ttzytt/hardware_vga_driver/Logisim/imgs/timing_diagram.png

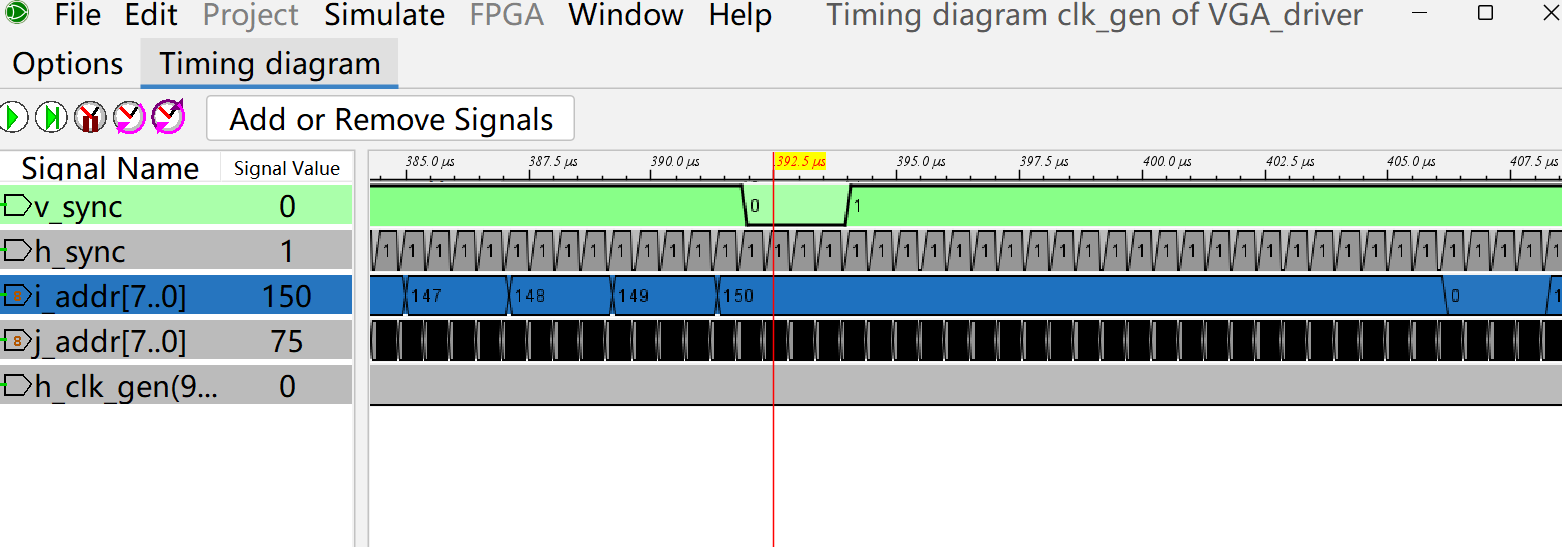
Logisim/imgs/timing_diagram.png
