ttzytt/hardware_vga_driver/Proposal/flowchart_v2.drawio.png

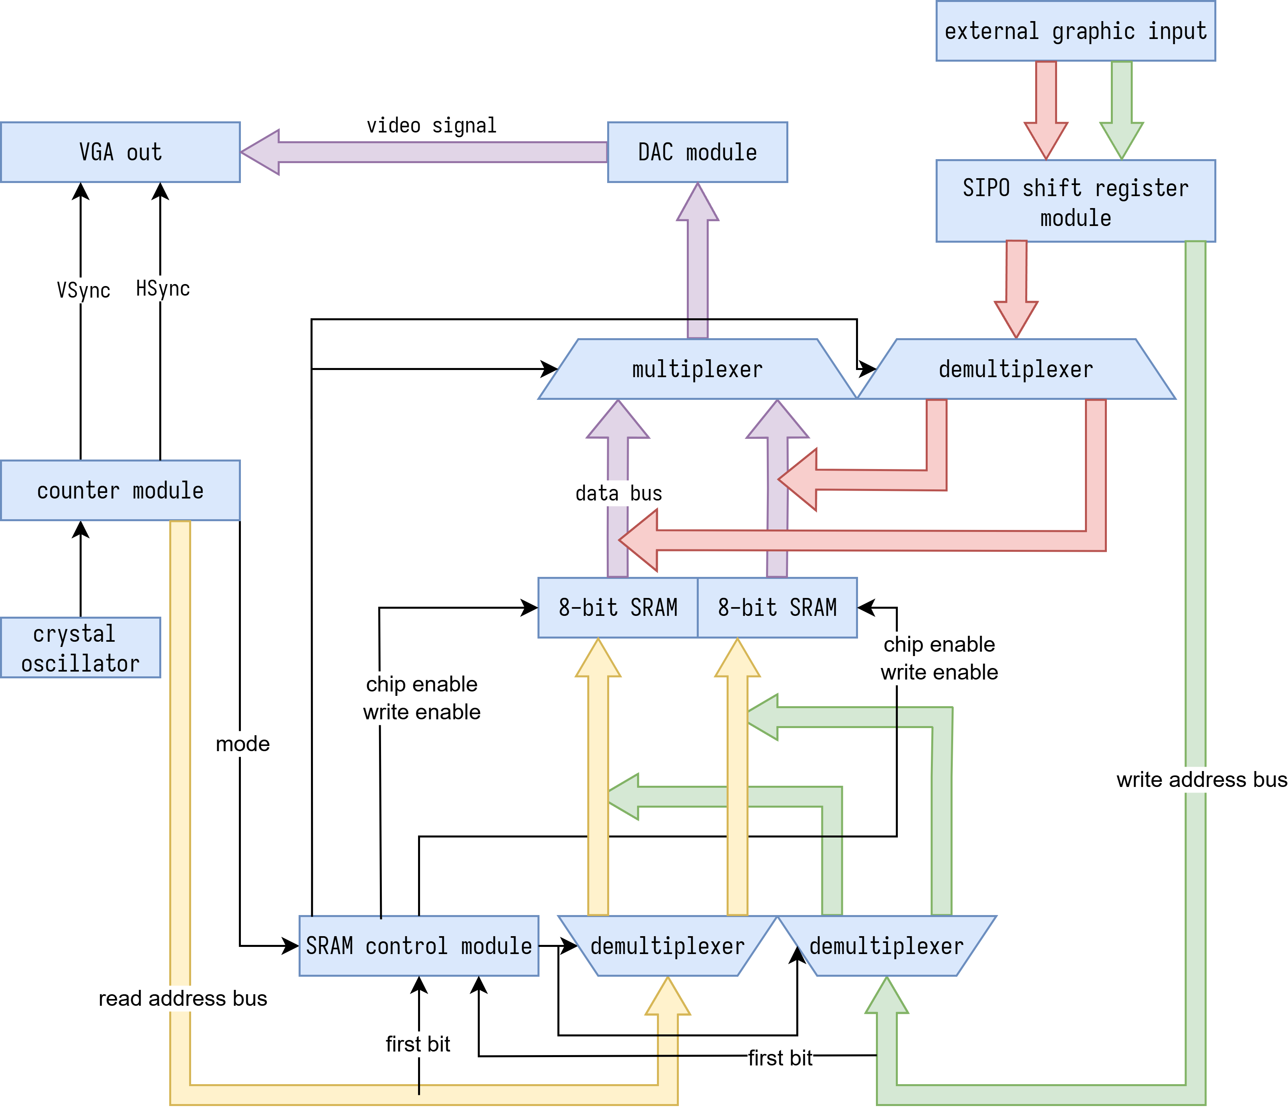
Proposal/flowchart_v2.drawio.png
