ttzytt/hardware_vga_driver/Proposal/flowchart.drawio.pdf

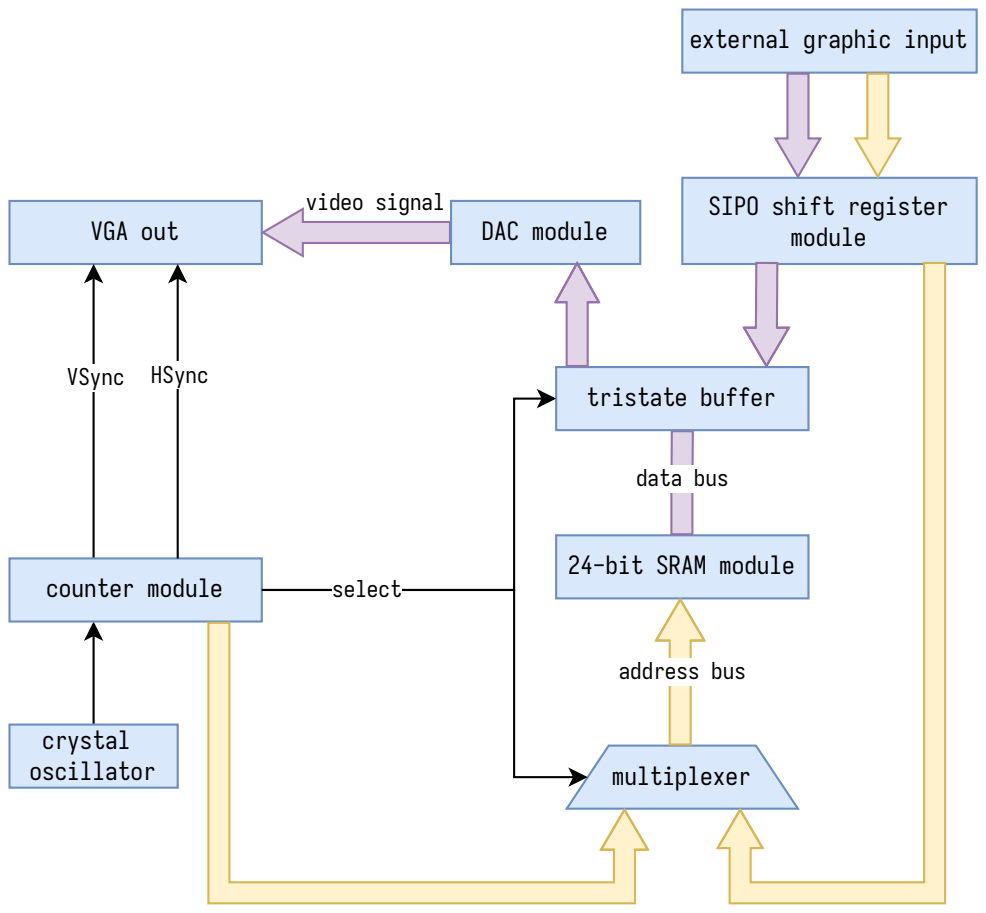
[picture p3: page 1]
VGA out; crystal oscillator; VSync; counter module; multiplexer; data; bus; HSync; address bus; tristate buffer; video signal; DAC module; select

external graphic input

SIPO shift register
module

24-bit SRAM module
