ttzytt/hardware_vga_driver/Proposal/flowchart_v2.drawio.pdf

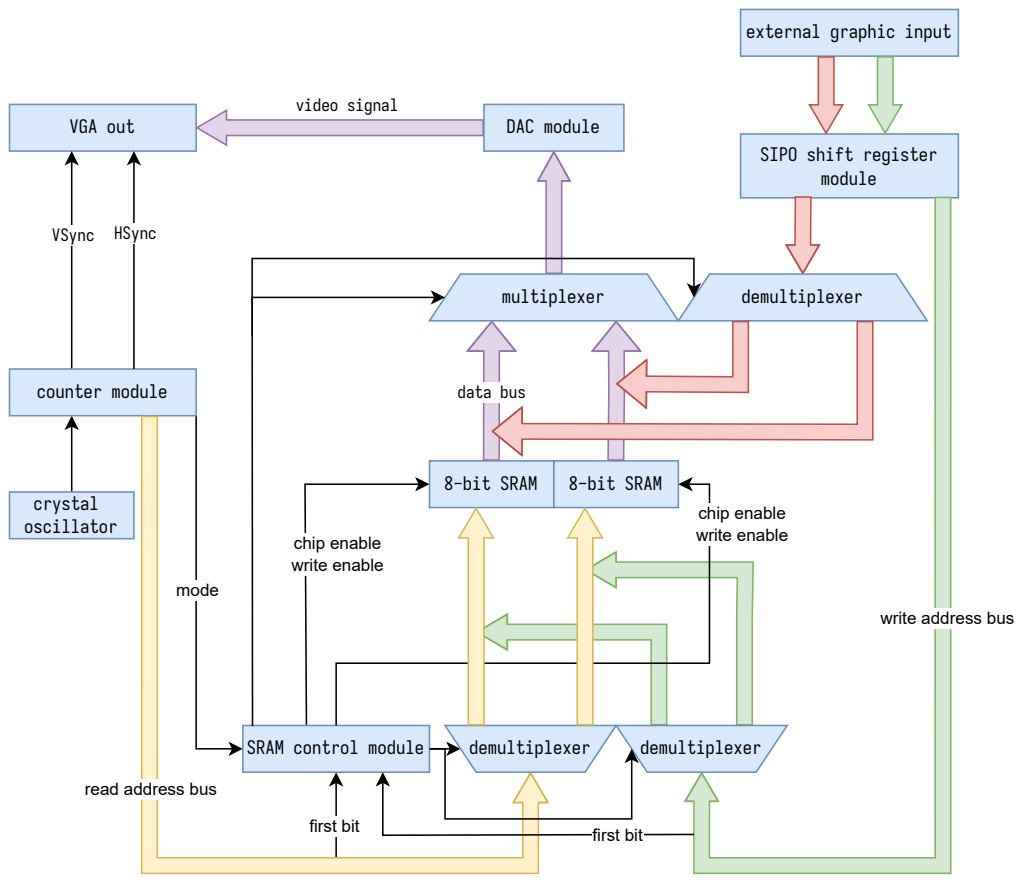
[picture p4: page 1]
first bit; VGA out; crystal oscillator; VSync; counter module; data bus; HSync; video signal; DAC module; SRAM control module; demultiplexer; multiplexer

external graphic input

SIPO shift register
module

8-bit SRAM | 8-bit SRAM

chip enable write enable

mode

write address bus

read address bus
