ttzytt/hardware_vga_driver/(list of files, drawings)

Other design files:
Logisim/VGA_driver.sync-conflict-20251006-233125-D54WMQZ.circ
