ttzytt/hardware_vga_driver/KiCAD/vga_video_card.kicad_pcb

## KiCad design KiCAD/vga_video_card.kicad_pcb (2025-11-28)

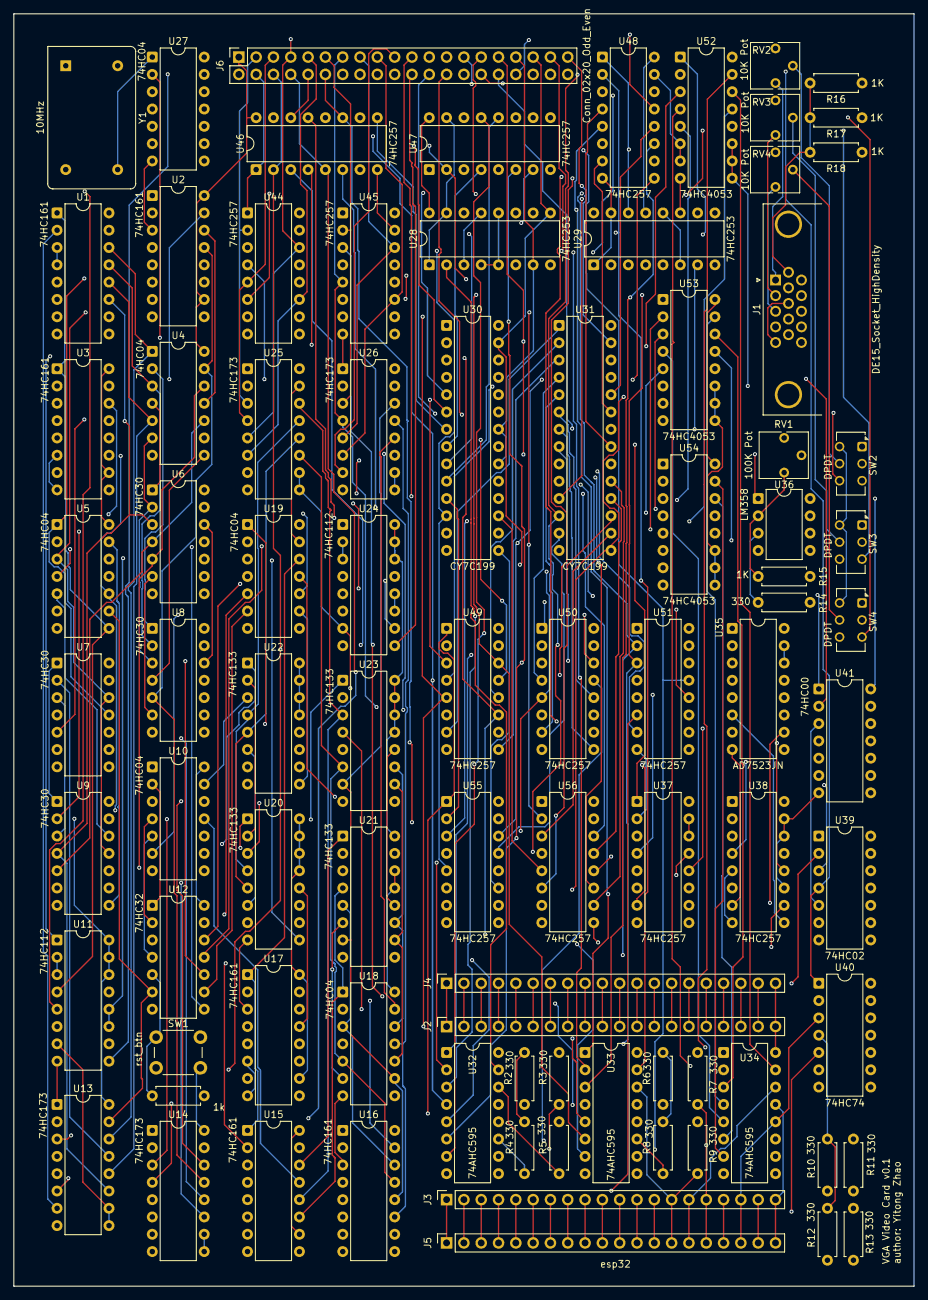
[picture p5: board vga_video_card.kicad_pcb from above]

Board: 4 copper layers, 132.1 x 186.7 mm, 87 parts (0 on the bottom side), 231 nets.

Parts:
J1: DE15_Socket_HighDensity; DSUB-15-HD_Socket_Horizontal_P2.29x1.90mm_EdgePinOffset3.03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
J2, J3, J4, J5: Conn_01x20; PinSocket_1x20_P2.54mm_Vertical
J6: Conn_02x20_Odd_Even; PinSocket_2x20_P2.54mm_Vertical
R1: 1k; R_Axial_DIN0207_L6.3mm_D2.5mm_P7.62mm_Horizontal
R2, R3, R4, R5, R6, R7, R8, R9, R10, R11, R12, R13, R14: 330; R_Axial_DIN0207_L6.3mm_D2.5mm_P7.62mm_Horizontal
R15, R16, R17, R18: 1K; R_Axial_DIN0207_L6.3mm_D2.5mm_P7.62mm_Horizontal
RV1: 100K Pot; Potentiometer_Vishay_T73YP_Vertical
RV2, RV3, RV4: 10K Pot; Potentiometer_Vishay_T73YP_Vertical
SW1: rst_btn; SW_PUSH_6mm
SW2, SW3, SW4: DPDT; SW_CK_JS202011CQN_DPDT_Straight
U1, U2, U3, U15, U16, U17: 74HC161; DIP-16_W7.62mm
U4, U5, U10, U18, U19, U27: 74HC04; DIP-14_W7.62mm
U6, U7, U8, U9: 74HC30; DIP-14_W7.62mm
U11, U24: 74HC112; DIP-16_W7.62mm
U12: 74HC32; DIP-14_W7.62mm
U13, U14, U25, U26: 74HC173; DIP-16_W7.62mm
U20, U21, U22, U23: 74HC133; DIP-16_W7.62mm
U28, U29: 74HC253; DIP-16_W7.62mm
U30, U31: CY7C199; DIP-28_W7.62mm
U32, U33, U34: 74AHC595; DIP-16_W7.62mm
U35: AD7523JN; DIP-16_W7.62mm
U36: LM358; DIP-8_W7.62mm
U37, U38, U44, U45, U46, U47, U48, U49, U50, U51, U55, U56: 74HC257; DIP-16_W7.62mm
U39: 74HC02; DIP-14_W7.62mm
U40: 74HC74; DIP-14_W7.62mm
U41: 74HC00; DIP-14_W7.62mm
U52, U53, U54: 74HC4053; DIP-16_W7.62mm
Y1: 10MHz; Oscillator_DIP-14

Connections:
+5V: J2.20, J4.20, J6.1, R2.2, R3.2, R4.2, R5.2, R6.2, R7.2, R8.2, R9.2, R10.2, R11.2, R12.2, R13.2, SW1.2, U1.7 (CEP), U1.10 (CET), U1.16 (VCC), U2.7 (CEP), U2.10 (CET), U2.16 (VCC), U3.7 (CEP), U3.10 (CET), U3.16 (VCC), U4.14 (VCC), U5.14 (VCC), U6.14 (VCC), U7.14 (VCC), U8.14 (VCC), U9.14 (VCC), U10.14 (VCC), U11.14 (~R), U11.15 (~R), U11.16 (VCC), U12.14 (VCC), U13.16 (VCC), U14.16 (VCC), U15.7 (CEP), U15.10 (CET), U15.16 (VCC), U16.7 (CEP), U16.10 (CET), U16.16 (VCC), U17.7 (CEP), U17.10 (CET), U17.16 (VCC), U18.14 (VCC), U19.14 (VCC), U20.13, U20.14, U20.15, U20.16 (VCC), U21.13, U21.14, U21.15, U21.16 (VCC), U22.13, U22.14, U22.15, U22.16 (VCC), U23.13, U23.14, U23.15, U23.16 (VCC), U24.14 (~R), U24.15 (~R), U24.16 (VCC), U25.16 (VCC), U26.16 (VCC), U27.14 (VCC), U28.3 (I3a), U28.10 (I0b), U28.11 (I1b), U28.13 (I3b), U28.16 (VCC), U29.6 (I0a), U29.10 (I0b), U29.12 (I2b), U29.13 (I3b), U29.16 (VCC), U30.28 (VCC), U31.28 (VCC), U32.16 (VCC), U33.16 (VCC), U34.16 (VCC), U35.14 (VCC), U35.15 (VREF), U36.8 (V+), U37.16 (VCC), U38.16 (VCC), U39.14 (VCC), U40.2 (D), U40.4 (~S), U40.14 (VCC), U41.14 (VCC), U44.16 (VCC), U45.16 (VCC), U46.16 (VCC), U47.16 (VCC), U48.16 (VCC), U49.16 (VCC), U50.16 (VCC), U51.16 (VCC), U52.16 (VDD), U53.16 (VDD), U54.16 (VDD), U55.16 (VCC), U56.16 (VCC), Y1.1 (EN), Y1.14 (Vcc)
/ADC_module/D0: U35.13 (D0(LSB)), U37.4 (Za)
/ADC_module/D1: U35.12 (D1), U37.7 (Zb)
/ADC_module/D2: U35.11 (D2), U37.12 (Zc)
/ADC_module/D3: U35.10 (D3), U37.9 (Zd)
/ADC_module/D4: U35.9 (D4), U38.4 (Za)
/ADC_module/D5: U35.8 (D5), U38.7 (Zb)
/ADC_module/D6: U35.7 (D6), U38.12 (Zc)
/ADC_module/D7: U35.6 (D7), U38.9 (Zd)
/ADC_module/I0: U37.3 (I1a), U55.4 (Za)
/ADC_module/I1: U37.6 (I1b), U55.7 (Zb)
/ADC_module/I2: U37.13 (I1c), U55.12 (Zc)
/ADC_module/I3: U37.10 (I1d), U55.9 (Zd)
/ADC_module/I4: U38.3 (I1a), U56.4 (Za)
/ADC_module/I5: U38.6 (I1b), U56.7 (Zb)
/ADC_module/I6: U38.13 (I1c), U56.12 (Zc)
/ADC_module/I7: U38.10 (I1d), U56.9 (Zd)
/RAM0_~CE: J6.33, U28.7 (Za), U30.20 (~CE), U30.22 (~OE)
/RAM0_~WE: J6.35, U28.9 (Zb), U30.27 (~WE), U41.1
/RAM1_~CE: J6.37, U29.7 (Za), U31.20 (~CE), U31.22 (~OE)
/RAM1_~WE: J6.39, U29.9 (Zb), U31.27 (~WE), U41.2
/RAM_module/RAM0_a0: U30.21 (A0), U44.4 (Za)
/RAM_module/RAM0_a1: U30.23 (A1), U44.7 (Zb)
/RAM_module/RAM0_a2: U30.24 (A2), U44.12 (Zc)
/RAM_module/RAM0_a3: U30.25 (A3), U44.9 (Zd)
/RAM_module/RAM0_a4: U30.26 (A4), U45.4 (Za)
/RAM_module/RAM0_a5: U30.1 (A5), U45.7 (Zb)
/RAM_module/RAM0_a6: U30.2 (A6), U45.12 (Zc)
/RAM_module/RAM0_a7: U30.3 (A7), U45.9 (Zd)
/RAM_module/RAM0_a8: U30.4 (A8), U46.4 (Za)
/RAM_module/RAM0_a9: U30.5 (A9), U46.7 (Zb)
/RAM_module/RAM0_a10: U30.6 (A10), U46.12 (Zc)
/RAM_module/RAM0_a11: U30.7 (A11), U46.9 (Zd)
/RAM_module/RAM0_a12: U30.8 (A12), U47.4 (Za)
/RAM_module/RAM0_a13: U30.9 (A13), U47.7 (Zb)
/RAM_module/RAM0_a14: U30.10 (A14), U47.12 (Zc)
/RAM_module/RAM0_d0: U30.11 (D0), U52.13 (X1), U55.2 (I0a)
/RAM_module/RAM0_d1: U30.12 (D1), U52.1 (Y1), U55.5 (I0b)
/RAM_module/RAM0_d2: U30.13 (D2), U52.3 (Z1), U55.14 (I0c)
/RAM_module/RAM0_d3: U30.15 (D3), U53.13 (X1), U55.11 (I0d)
/RAM_module/RAM0_d4: U30.16 (D4), U53.1 (Y1), U56.2 (I0a)
/RAM_module/RAM0_d5: U30.17 (D5), U53.3 (Z1), U56.5 (I0b)
/RAM_module/RAM0_d6: U30.18 (D6), U54.13 (X1), U56.14 (I0c)
/RAM_module/RAM0_d7: U30.19 (D7), U54.1 (Y1), U56.11 (I0d)
/RAM_module/RAM1_a0: U31.21 (A0), U48.4 (Za)
/RAM_module/RAM1_a1: U31.23 (A1), U48.7 (Zb)
/RAM_module/RAM1_a2: U31.24 (A2), U48.12 (Zc)
/RAM_module/RAM1_a3: U31.25 (A3), U48.9 (Zd)
/RAM_module/RAM1_a4: U31.26 (A4), U49.4 (Za)
/RAM_module/RAM1_a5: U31.1 (A5), U49.7 (Zb)
/RAM_module/RAM1_a6: U31.2 (A6), U49.12 (Zc)
/RAM_module/RAM1_a7: U31.3 (A7), U49.9 (Zd)
/RAM_module/RAM1_a8: U31.4 (A8), U50.4 (Za)
/RAM_module/RAM1_a9: U31.5 (A9), U50.7 (Zb)
/RAM_module/RAM1_a10: U31.6 (A10), U50.12 (Zc)
/RAM_module/RAM1_a11: U31.7 (A11), U50.9 (Zd)
/RAM_module/RAM1_a12: U31.8 (A12), U51.4 (Za)
/RAM_module/RAM1_a13: U31.9 (A13), U51.7 (Zb)
/RAM_module/RAM1_a14: U31.10 (A14), U51.12 (Zc)
/RAM_module/RAM1_d0: U31.11 (D0), U52.12 (X0), U55.3 (I1a)
/RAM_module/RAM1_d1: U31.12 (D1), U52.2 (Y0), U55.6 (I1b)
/RAM_module/RAM1_d2: U31.13 (D2), U52.5 (Z0), U55.13 (I1c)
/RAM_module/RAM1_d3: U31.15 (D3), U53.12 (X0), U55.10 (I1d)
/RAM_module/RAM1_d4: U31.16 (D4), U53.2 (Y0), U56.3 (I1a)
/RAM_module/RAM1_d5: U31.17 (D5), U53.5 (Z0), U56.6 (I1b)
/RAM_module/RAM1_d6: U31.18 (D6), U54.12 (X0), U56.13 (I1c)
/RAM_module/RAM1_d7: U31.19 (D7), U54.2 (Y0), U56.10 (I1d)
/RAM_module/RAM_bus_mux/w_addr0: U33.15 (QA), U44.3 (I1a), U48.2 (I0a)
/RAM_module/RAM_bus_mux/w_addr1: U33.1 (QB), U44.6 (I1b), U48.5 (I0b)
/RAM_module/RAM_bus_mux/w_addr2: U33.2 (QC), U44.13 (I1c), U48.14 (I0c)
/RAM_module/RAM_bus_mux/w_addr3: U33.3 (QD), U44.10 (I1d), U48.11 (I0d)
/RAM_module/RAM_bus_mux/w_addr4: U33.4 (QE), U45.3 (I1a), U49.2 (I0a)
/RAM_module/RAM_bus_mux/w_addr5: U33.5 (QF), U45.6 (I1b), U49.5 (I0b)
/RAM_module/RAM_bus_mux/w_addr6: U33.6 (QG), U45.13 (I1c), U49.14 (I0c)
/RAM_module/RAM_bus_mux/w_addr7: U33.7 (QH), U45.10 (I1d), U49.11 (I0d)
/RAM_module/RAM_bus_mux/w_addr8: U32.1 (QB), U46.3 (I1a), U50.2 (I0a)
/RAM_module/RAM_bus_mux/w_addr9: U32.2 (QC), U46.6 (I1b), U50.5 (I0b)
/RAM_module/RAM_bus_mux/w_addr10: U32.3 (QD), U46.13 (I1c), U50.14 (I0c)
/RAM_module/RAM_bus_mux/w_addr11: U32.4 (QE), U46.10 (I1d), U50.11 (I0d)
/RAM_module/RAM_bus_mux/w_addr12: U32.5 (QF), U47.3 (I1a), U51.2 (I0a)
/RAM_module/RAM_bus_mux/w_addr13: U32.6 (QG), U47.6 (I1b), U51.5 (I0b)
/RAM_module/RAM_bus_mux/w_addr14: U32.7 (QH), U47.13 (I1c), U51.14 (I0c)
/RAM_module/RAM_bus_mux/w_data0: U34.15 (QA), U52.14 (X)
/RAM_module/RAM_bus_mux/w_data1: U34.1 (QB), U52.15 (Y)
/RAM_module/RAM_bus_mux/w_data2: U34.2 (QC), U52.4 (Z)
/RAM_module/RAM_bus_mux/w_data3: U34.3 (QD), U53.14 (X)
/RAM_module/RAM_bus_mux/w_data4: U34.4 (QE), U53.15 (Y)
/RAM_module/RAM_bus_mux/w_data5: U34.5 (QF), U53.4 (Z)
/RAM_module/RAM_bus_mux/w_data6: U34.6 (QG), U54.14 (X)
/RAM_module/RAM_bus_mux/w_data7: U34.7 (QH), U54.15 (Y)
/RAM_module/RAM_bus_mux/w_j_addr0: U28.2 (A1), U29.2 (A1), U32.15 (QA)
/RAM_module/await_upd: J3.1, J5.1, U40.5 (Q)
/RAM_module/ext_graphics_rclk: J3.18, J5.18, R2.1, R6.1, R10.1, U32.12 (RCLK), U33.12 (RCLK), U34.12 (RCLK), U40.3 (C)
/RAM_module/ext_graphics_source/data_ser: J3.15, J5.15, R13.1, U34.14 (SER)
/RAM_module/ext_graphics_source/data_srclk: J3.17, J5.17, R4.1, R8.1, R12.1, U32.11 (SRCLK), U33.11 (SRCLK), U34.11 (SRCLK)
/RAM_module/ext_graphics_source/data_~srclr: J3.16, J5.16, R3.1, R7.1, R11.1, U32.10 (~SRCLR), U33.10 (~SRCLR), U34.10 (~SRCLR)
/RAM_module/ext_graphics_source/i_addr_ser: J3.14, J5.14, R9.1, U33.14 (SER)
/RAM_module/ext_graphics_source/j_addr_ser: J3.13, J5.13, R5.1, U32.14 (SER)
/RAM_module/r_i_addr0: J6.3, U25.3 (Q0), U44.2 (I0a), U48.3 (I1a)
/RAM_module/r_i_addr1: J6.5, U25.4 (Q1), U44.5 (I0b), U48.6 (I1b)
/RAM_module/r_i_addr2: J6.7, U25.5 (Q2), U44.14 (I0c), U48.13 (I1c)
/RAM_module/r_i_addr3: J6.9, U25.6 (Q3), U44.11 (I0d), U48.10 (I1d)
/RAM_module/r_i_addr4: J6.11, U26.3 (Q0), U45.2 (I0a), U49.3 (I1a)
/RAM_module/r_i_addr5: J6.13, U26.4 (Q1), U45.5 (I0b), U49.6 (I1b)
/RAM_module/r_i_addr6: J6.15, U26.5 (Q2), U45.14 (I0c), U49.13 (I1c)
/RAM_module/r_i_addr7: J6.17, U26.6 (Q3), U45.11 (I0d), U49.10 (I1d)
/RAM_module/r_j_addr0: J6.4, U13.3 (Q0), U28.14 (A0), U29.14 (A0), U44.1 (S), U45.1 (S), U46.1 (S), U47.1 (S), U48.1 (S), U49.1 (S), U50.1 (S), U51.1 (S), U52.9 (C), U52.10 (B), U52.11 (A), U53.9 (C), U53.10 (B), U53.11 (A), U54.9 (C), U54.10 (B), U54.11 (A), U55.1 (S), U56.1 (S)
/RAM_module/r_j_addr1: J6.6, U13.4 (Q1), U46.2 (I0a), U50.3 (I1a)
/RAM_module/r_j_addr2: J6.8, U13.5 (Q2), U46.5 (I0b), U50.6 (I1b)
/RAM_module/r_j_addr3: J6.10, U13.6 (Q3), U46.14 (I0c), U50.13 (I1c)
/RAM_module/r_j_addr4: J6.12, U14.3 (Q0), U46.11 (I0d), U50.10 (I1d)
/RAM_module/r_j_addr5: J6.14, U14.4 (Q1), U47.2 (I0a), U51.3 (I1a)
/RAM_module/r_j_addr6: J6.16, U14.5 (Q2), U47.5 (I0b), U51.6 (I1b)
/RAM_module/r_j_addr7: J6.18, U14.6 (Q3), U47.14 (I0c), U51.13 (I1c)
/VGA_B: J1.3, J6.27, R18.1, RV4.1
/VGA_G: J1.2, J6.25, R17.1, RV3.1
/VGA_R: J1.1, J6.23, R16.1, RV2.1
/eo_frame: J6.21, U12.12, U19.10
/eo_line: J6.19, U5.10, U10.5, U12.4, U15.2 (CP), U25.7 (Cp), U26.7 (Cp)
/ext_B: J6.30, SW4.3 (C), SW4.4 (A)
/ext_G: J6.28, SW3.3 (C), SW3.4 (A)
/ext_R: J6.26, SW2.3 (C), SW2.4 (A)
/h_sync: J1.13, J6.29, U11.5 (Q)
/horizontal_counter/CLK: U1.2 (CP), U13.7 (Cp), U14.7 (Cp), U27.1, Y1.8 (OUT)
/horizontal_counter/bit_0: U1.14 (Q0), U4.1, U13.14 (D0)
/horizontal_counter/bit_1: U1.13 (Q1), U4.3, U7.2, U8.2, U13.13 (D1)
/horizontal_counter/bit_2: U1.12 (Q2), U4.5, U13.12 (D2)
/horizontal_counter/bit_3: U1.11 (Q3), U4.9, U6.3, U9.4, U13.11 (D3)
/horizontal_counter/bit_4: U2.14 (Q0), U4.11, U7.5, U14.14 (D0)
/horizontal_counter/bit_5: U2.13 (Q1), U4.13, U7.6, U8.5, U14.13 (D1)
/horizontal_counter/bit_6: U2.12 (Q2), U5.1, U7.11, U14.12 (D2)
/horizontal_counter/bit_7: U2.11 (Q3), U5.3, U7.12, U8.11, U9.11, U14.11 (D3)
/horizontal_counter/bit_8: U3.14 (Q0), U5.5, U6.12, U8.12, U9.12
/horizontal_counter/eo_fporch_210: U10.2, U12.1
/horizontal_counter/eo_syncp_242: U10.4, U12.2
/horizontal_counter/eo_vis_200: U5.12, U11.11 (J), U11.12 (K)
/horizontal_counter/rst: U5.9, U12.6, U13.15 (Mr), U14.15 (Mr)
/horizontal_counter/~CLK: U11.1 (C), U11.13 (C), U27.2
/horizontal_counter/~bit_0: U4.2, U7.1, U8.1, U9.1
/horizontal_counter/~bit_1: U4.4, U6.1, U9.2
/horizontal_counter/~bit_2: U4.6, U6.2, U7.3, U8.3, U9.3
/horizontal_counter/~bit_3: U4.8, U7.4, U8.4
/horizontal_counter/~bit_4: U4.10, U6.4, U9.5
/horizontal_counter/~bit_5: U4.12, U6.5, U9.6
/horizontal_counter/~bit_6: U5.2, U6.6, U8.6
/horizontal_counter/~bit_7: U5.4, U6.11
/horizontal_counter/~eo_line: U10.6, U24.1 (C), U24.13 (C)
/horizontal_counter/~is_h_vis_area: U11.7 (~Q), U13.9 (E1), U13.10 (E2), U14.9 (E1), U14.10 (E2), U39.2
/horizontal_counter/~rst: U1.1 (~MR), U2.1 (~MR), U3.1 (~MR), U5.8, U11.4 (~S), U11.10 (~S)
/int_brightness: J6.32, RV1.2, SW2.1 (A), SW2.6 (C), SW3.1 (A), SW3.6 (C), SW4.1 (A), SW4.6 (C), U36.1
/is_h_vis_area: J6.20, U11.9 (Q)
/is_v_vis_area: J6.22, U24.9 (Q)
/is_vis_area: J6.24, U37.1 (S), U38.1 (S), U39.1
/mrst: R1.2, SW1.1, U12.5, U12.13, U39.6
/v_sync: J1.14, J6.31, U24.5 (Q)
/vertical_counter/bit_0: U10.9, U15.14 (Q0), U21.1, U22.1
/vertical_counter/bit_1: U10.11, U15.13 (Q1)
/vertical_counter/bit_2: U10.13, U15.12 (Q2), U22.3, U23.3, U25.14 (D0)
/vertical_counter/bit_3: U15.11 (Q3), U18.1, U20.4, U21.4, U22.4, U25.13 (D1)
/vertical_counter/bit_4: U16.14 (Q0), U18.3, U20.5, U21.5, U22.5, U23.5, U25.12 (D2)
/vertical_counter/bit_5: U16.13 (Q1), U18.5, U23.6, U25.11 (D3)
/vertical_counter/bit_6: U16.12 (Q2), U18.9, U20.7, U21.7, U22.7, U23.7, U26.14 (D0)
/vertical_counter/bit_7: U16.11 (Q3), U18.11, U26.13 (D1)
/vertical_counter/bit_8: U17.14 (Q0), U18.13, U26.12 (D2)
/vertical_counter/bit_9: U17.13 (Q1), U19.1, U20.12, U21.12, U22.12, U23.12, U26.11 (D3)
/vertical_counter/eo_fporch_601: U12.9, U19.6
/vertical_counter/eo_syncp_605: U12.10, U19.8
/vertical_counter/eo_vis_600: U19.4, U24.11 (J), U24.12 (K)
/vertical_counter/rst: U12.11, U19.13, U25.15 (Mr), U26.15 (Mr)
/vertical_counter/~bit_0: U10.8, U20.1, U23.1
/vertical_counter/~bit_1: U10.10, U20.2, U21.2, U22.2, U23.2
/vertical_counter/~bit_2: U10.12, U20.3, U21.3
/vertical_counter/~bit_3: U18.2, U23.4
/vertical_counter/~bit_5: U18.6, U20.6, U21.6, U22.6
/vertical_counter/~bit_7: U18.10, U20.10, U21.10, U22.10, U23.10
/vertical_counter/~bit_8: U18.12, U20.11, U21.11, U22.11, U23.11
/vertical_counter/~is_v_vis_area: U24.7 (~Q), U25.9 (E1), U25.10 (E2), U26.9 (E1), U26.10 (E2), U39.3
/vertical_counter/~rst: U15.1 (~MR), U16.1 (~MR), U17.1 (~MR), U19.12, U24.4 (~S), U24.10 (~S)
/writing_RAM: J6.34, U39.4, U40.1 (~R)
GND: J1.5, J1.6, J1.7, J1.8, J1.10, J3.20, J5.20, J6.2, R1.1, R14.2, R15.2, R16.2, R17.2, R18.2, U1.3 (D0), U1.4 (D1), U1.5 (D2), U1.6 (D3), U1.8 (GND), U1.9 (~PE), U2.3 (D0), U2.4 (D1), U2.5 (D2), U2.6 (D3), U2.8 (GND), U2.9 (~PE), U3.3 (D0), U3.4 (D1), U3.5 (D2), U3.6 (D3), U3.8 (GND), U3.9 (~PE), U4.7 (GND), U5.7 (GND), U6.7 (GND), U7.7 (GND), U8.7 (GND), U9.7 (GND), U10.7 (GND), U11.8 (GND), U12.7 (GND), U13.1 (Oe1), U13.2 (Oe2), U13.8 (GND), U14.1 (Oe1), U14.2 (Oe2), U14.8 (GND), U15.3 (D0), U15.4 (D1), U15.5 (D2), U15.6 (D3), U15.8 (GND), U15.9 (~PE), U16.3 (D0), U16.4 (D1), U16.5 (D2), U16.6 (D3), U16.8 (GND), U16.9 (~PE), U17.3 (D0), U17.4 (D1), U17.5 (D2), U17.6 (D3), U17.8 (GND), U17.9 (~PE), U18.7 (GND), U19.7 (GND), U20.8 (GND), U21.8 (GND), U22.8 (GND), U23.8 (GND), U24.8 (GND), U25.1 (Oe1), U25.2 (Oe2), U25.8 (GND), U26.1 (Oe1), U26.2 (Oe2), U26.8 (GND), U27.7 (GND), U28.1 (OEa), U28.4 (I2a), U28.5 (I1a), U28.6 (I0a), U28.8 (GND), U28.12 (I2b), U28.15 (OEb), U29.1 (OEa), U29.3 (I3a), U29.4 (I2a), U29.5 (I1a), U29.8 (GND), U29.11 (I1b), U29.15 (OEb), U30.14 (GND), U31.14 (GND), U32.8 (GND), U32.13 (~OE), U33.8 (GND), U33.13 (~OE), U34.8 (GND), U34.13 (~OE), U35.2 (I_OUT2), U35.3 (GND), U36.4 (V-), U37.2 (I0a), U37.5 (I0b), U37.8 (GND), U37.11 (I0d), U37.14 (I0c), U37.15 (OE), U38.2 (I0a), U38.5 (I0b), U38.8 (GND), U38.11 (I0d), U38.14 (I0c), U38.15 (OE), U39.7 (GND), U40.7 (GND), U41.7 (GND), U44.8 (GND), U44.15 (OE), U45.8 (GND), U45.15 (OE), U46.8 (GND), U46.15 (OE), U47.8 (GND), U47.15 (OE), U48.8 (GND), U48.15 (OE), U49.8 (GND), U49.15 (OE), U50.8 (GND), U50.15 (OE), U51.8 (GND), U51.15 (OE), U52.6 (Inh), U52.7 (VEE), U52.8 (VSS), U53.6 (Inh), U53.7 (VEE), U53.8 (VSS), U54.6 (Inh), U54.7 (VEE), U54.8 (VSS), U55.8 (GND), U55.15 (OE), U56.8 (GND), U56.15 (OE), Y1.7 (GND)
unnamed: J2.1, J4.1
unnamed: J2.2, J4.2
unnamed: J2.3, J4.3
unnamed: J2.4, J4.4
unnamed: J2.5, J4.5
unnamed: J2.6, J4.6
unnamed: J2.7, J4.7
unnamed: J2.8, J4.8
unnamed: J2.9, J4.9
unnamed: J2.10, J4.10
unnamed: J2.11, J4.11
unnamed: J2.12, J4.12
unnamed: J2.13, J4.13
unnamed: J2.14, J4.14
unnamed: J2.15, J4.15
unnamed: J2.16, J4.16
unnamed: J2.17, J4.17
unnamed: J2.18, J4.18
unnamed: J2.19, J4.19
unnamed: J3.2, J5.2
unnamed: J3.3, J5.3
unnamed: J3.4, J5.4
unnamed: J3.5, J5.5
unnamed: J3.6, J5.6
unnamed: J3.7, J5.7
unnamed: J3.8, J5.8
unnamed: J3.9, J5.9
unnamed: J3.10, J5.10
unnamed: J3.11, J5.11
unnamed: J3.12, J5.12
unnamed: J3.19, J5.19
unnamed: RV2.2, SW2.2 (B), SW2.5 (B)
unnamed: RV3.2, SW3.2 (B), SW3.5 (B)
unnamed: RV4.2, SW4.2 (B), SW4.5 (B)
unnamed: U1.15 (TC), U2.2 (CP)
unnamed: U2.15 (TC), U3.2 (CP)
unnamed: U5.11, U6.8
unnamed: U5.13, U9.8
unnamed: U8.8, U10.1
unnamed: U7.8, U10.3
unnamed: U11.2 (K), U11.3 (J), U12.3
unnamed: U15.15 (TC), U16.2 (CP)
unnamed: U16.15 (TC), U17.2 (CP)
unnamed: U19.3, U20.9
unnamed: U19.5, U21.9
unnamed: U19.9, U22.9
unnamed: U19.11, U23.9
unnamed: U12.8, U24.2 (K), U24.3 (J)
unnamed: R14.1, U35.1 (I_OUT1), U36.3 (+)
unnamed: R15.1, RV1.1, U36.2 (-)
unnamed: U39.5, U41.3
