ttzytt/hardware_vga_driver/esp_disp_driver/src/bin/main.rs

#![no_std]
#![no_main]
#![deny(
    clippy::mem_forget,
    reason = "mem::forget is generally not safe to do with esp_hal types, especially those \
    holding buffers for the duration of a data transfer."
)]

use bt_hci::controller::ExternalController;
use defmt::{info, println};
use embassy_executor::Spawner;
use embassy_time::{Duration, Timer};
use esp_hal::{clock::CpuClock, gpio::Output, gpio};
use esp_hal::timer::timg::TimerGroup;
use esp_hal::gpio::OutputConfig;
use esp_radio::ble::controller::BleConnector;
use panic_rtt_target as _;
use trouble_host::prelude::*;
use esp_disp_driver::sipo;
extern crate alloc;

const CONNECTIONS_MAX: usize = 1;
const L2CAP_CHANNELS_MAX: usize = 1;

// This creates a default app-descriptor required by the esp-idf bootloader.
// For more information see: <https://docs.espressif.com/projects/esp-idf/en/stable/esp32/api-reference/system/app_image_format.html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>
esp_bootloader_esp_idf::esp_app_desc!();

#[esp_rtos::main]
async fn main(spawner: Spawner) -> ! {
    // generator version: 1.0.1

    rtt_target::rtt_init_defmt!();

    let config = esp_hal::Config::default().with_cpu_clock(CpuClock::max());
    let mut peripherals = esp_hal::init(config);

    esp_alloc::heap_allocator!(#[esp_hal::ram(reclaimed)] size: 73744);
    // COEX needs more RAM - so we've added some more
    esp_alloc::heap_allocator!(size: 64 * 1024);

    let timg0 = TimerGroup::new(peripherals.TIMG0);
    esp_rtos::start(timg0.timer0);

    info!("Embassy initialized!");

    let radio_init = esp_radio::init().expect("Failed to initialize Wi-Fi/BLE controller");
    let (mut _wifi_controller, _interfaces) =
        esp_radio::wifi::new(&radio_init, peripherals.WIFI, Default::default())
            .expect("Failed to initialize Wi-Fi controller");
    // find more examples https://github.com/embassy-rs/trouble/tree/main/examples/esp32
    let transport = BleConnector::new(&radio_init, peripherals.BT, Default::default()).unwrap();
    let ble_controller = ExternalController::<_, 20>::new(transport);
    let mut resources: HostResources<DefaultPacketPool, CONNECTIONS_MAX, L2CAP_CHANNELS_MAX> =
        HostResources::new();
    let _stack = trouble_host::new(ble_controller, &mut resources);
    
    // TODO: Spawn some tasks
    let _ = spawner;

    loop {
        info!("Hello, world!");
        Timer::after(Duration::from_secs(5)).await;
    }

    // for inspiration have a look at the examples at https://github.com/esp-rs/esp-hal/tree/esp-hal-v1.0.0/examples/src/bin
}
