ttzytt/hardware_vga_driver/(commit log)

2025-10-01 finished SRAM_controller and changed some naming
    [VGA_driver.circ]
2025-10-03 impl bus_mux and SRAM_controller
    [VGA_driver.circ]
2025-10-03 impl SRAM_module
    [VGA_driver.circ]
2025-11-12 started driver code
    [VGA_driver.sync-conflict-20251006-233125-D54WMQZ.circ]
2025-11-15 switched to probe-rs and JTAG as the flashing problem has been fixed
    [main.rs, sipo.rs]
2025-11-22 finished schematics for hcounter, working on vcounter; rust code need to be cleaned up
    [horizontal_counter.kicad_sch, vertical_counter.kicad_sch, vga_video_card.kicad_pcb, vga_video_card.kicad_sch]
2025-11-24 assigned footprints
    [horizontal_counter.kicad_sch, vertical_counter.kicad_sch, vga_video_card.kicad_sch]
2025-11-26 finished most of the schematics of submodules except DAC, need to work on integration
    [15bit_2t1_MUX.kicad_sch, 8bit_2t1_MUX.kicad_sch, 8bit_2t1_analog_MUX.kicad_sch, RAM_bus_mux.kicad_sch, RAM_state_controller.kicad_sch, SRAM_controller.kicad_sch, SRAM_state_controller.kicad_sch, addr_combiner.kicad_sch]
2025-11-27 finished schematics and footprint assignments; need to figure out +5v connection issue
    [15bit_2t1_MUX.kicad_sch, 8bit_2t1_MUX.kicad_sch, RAM_state_controller.kicad_sch, ext_graphics_source.kicad_sch, horizontal_counter.kicad_sch, ram_module.kicad_sch, vertical_counter.kicad_sch, vga_video_card.kicad_sch]
2025-11-27 fix footprint
    [RAM_state_controller.kicad_sch, const_zero_8bit.kicad_sch, horizontal_counter.kicad_sch, vga_video_card.kicad_pcb, vga_video_card.kicad_sch]
2025-11-27 modified debug connector; changed board type in pcb editor
    [ADC_module.kicad_sch, const_zero_8bit.kicad_sch, ext_graphics_source.kicad_sch, ram_module.kicad_sch, vertical_counter.kicad_sch, vga_video_card.kicad_pcb, vga_video_card.kicad_sch]
2025-11-27 update pcb
    [horizontal_counter.kicad_sch, vga_video_card.kicad_pcb, vga_video_card.kicad_sch]
2025-11-27 fix multiple ERCs that made RAM addrs not connecting
    [15bit_2t1_MUX.kicad_sch, 8bit_2t1_MUX.kicad_sch, ADC_module.kicad_sch, RAM_bus_mux.kicad_sch, RAM_state_controller.kicad_sch, addr_combiner.kicad_sch, const_zero_8bit.kicad_sch, ext_graphics_source.kicad_sch]
2025-11-27 resolve ERCs for addr combiner
    [15bit_2t1_MUX.kicad_sch, RAM_bus_mux.kicad_sch, RAM_state_controller.kicad_sch, ext_graphics_source.kicad_sch, horizontal_counter.kicad_sch, ram_module.kicad_sch, vga_video_card.kicad_sch]
2025-11-27 clean up; resolve ERC warnings
    [15bit_2t1_MUX.kicad_sch, 8bit_2t1_MUX.kicad_sch, 8bit_2t1_analog_MUX.kicad_sch, RAM_bus_mux.kicad_sch, horizontal_counter.kicad_sch, vertical_counter.kicad_sch]
2025-11-27 resolved most ERC errors
    [RAM_bus_mux.kicad_sch, addr_combiner.kicad_sch, vertical_counter.kicad_sch, vga_video_card.kicad_sch]
2025-11-27 resolved all ERC errors, kicad got some stupid bugs
    [RAM_bus_mux.kicad_sch, addr_combiner.kicad_sch, horizontal_counter.kicad_sch, ram_module.kicad_sch, vga_video_card.kicad_pcb, vga_video_card.kicad_sch]
2025-11-28 partially finished pcb layout
    [vga_video_card.kicad_pcb, vga_video_card.kicad_sch]
2025-11-28 finished layout
    [vga_video_card.kicad_pcb, vga_video_card.kicad_sch]
2025-11-28 finished layout and silkscreen
    [addr_combiner2.kicad_sch, addr_combiner_helper.kicad_sch]
2025-11-28 resolve DRC warnings
    [vga_video_card.kicad_pcb]
2025-11-28 generate gerber file
    [vga_video_card-B_Cu.gbr, vga_video_card-B_Mask.gbr, vga_video_card-B_Paste.gbr, vga_video_card-B_Silkscreen.gbr, vga_video_card-Edge_Cuts.gbr, vga_video_card-F_Cu.gbr, vga_video_card-F_Mask.gbr, vga_video_card-F_Paste.gbr]
2025-11-28 add grill file
    [vga_video_card.kicad_pcb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]
2025-12-05 correct order of frame in PixelWriter::write_pixel
    [main.rs, pure_color_demo.rs, sipo.rs]
2025-12-15 updated KiCAD todos
    [ext_graphics_source.kicad_sch, horizontal_counter.kicad_sch, vertical_counter.kicad_sch]
2025-12-15 fixed the numbers of horizontal counter NAND gates
    [horizontal_counter.kicad_sch]
2025-12-15 schematics disabled PE
    [horizontal_counter.kicad_sch, vertical_counter.kicad_sch]
2025-12-17 add schematics todos for DAC and RAM state controller
    [ADC_module.kicad_sch, RAM_state_controller.kicad_sch]
2025-12-23 update DAC schematics; update pin layout for esp32 connector; update RAM state controller input pin
    [ADC_module.kicad_sch, RAM_state_controller.kicad_sch, ext_graphics_source.kicad_sch, vga_video_card.kicad_sch]
2025-12-24 passed DRC for PCB
    [ext_graphics_source.kicad_sch, ram_module.kicad_sch, vga_video_card.kicad_sch]
2025-12-25 fix ic orientation PCB
2025-12-25 refine silkscreen
2025-12-25 add fabrication files
    [vga_video_card-B_Cu.gbr, vga_video_card-B_Mask.gbr, vga_video_card-B_Paste.gbr, vga_video_card-B_Silkscreen.gbr, vga_video_card-Edge_Cuts.gbr, vga_video_card-F_Cu.gbr, vga_video_card-F_Mask.gbr, vga_video_card-F_Paste.gbr]
